batterylabunipi/TWIST/README.md

# TWIST
TWIST is an open framework for Li-ion cell characterization based on Python and Raspberry Pi
