batterylabunipi/TWIST/SW/Setting_File/chargerinfo.txt

#This file contains the model No. and the socket information about charger instrument

Model:		QPX1200SP

IPAddress:	192.168.1.101

Port:		9221
