batterylabunipi/TWIST/Docs/User_manual.pdf

## 18 febbraio 2018

# Two Wheels Instrument Station Tester (TWIST)

# User Manual

1Two Wheels Instrument Station Tester ⁽TWIST⁾ | 18/02/2018

# Two Wheels Instrument Station Tester (TWIST)

User Manual

# Summary

# 1 Hardware Framework

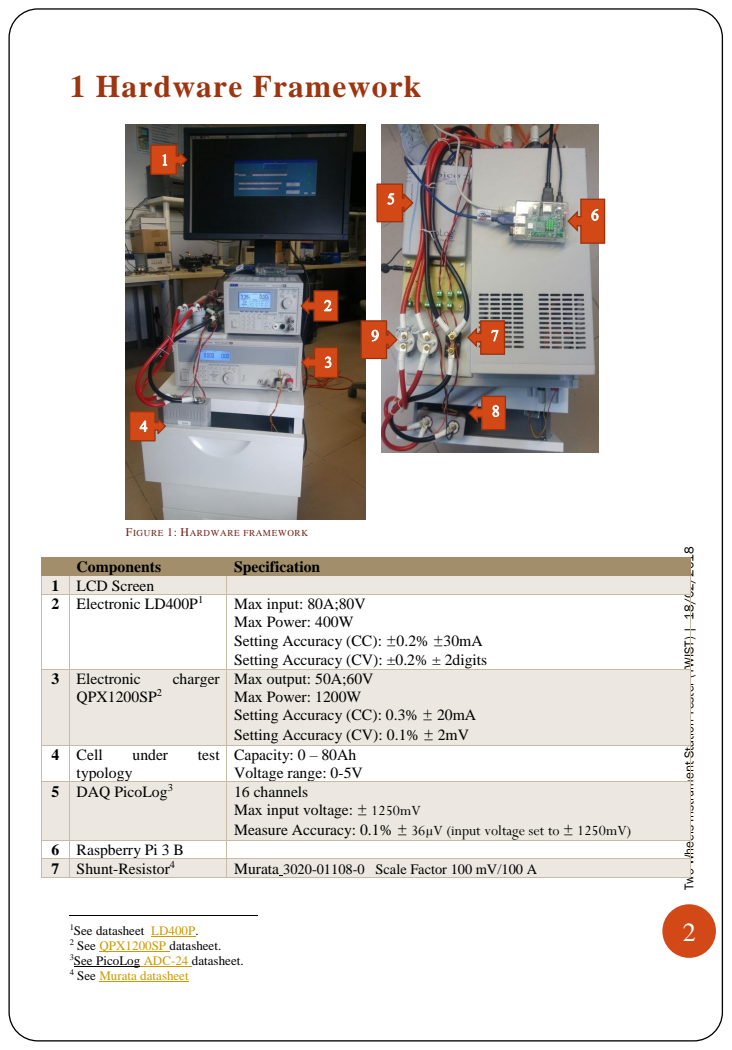
[picture p1: page 3]
Components; Specification

FIGURE 1: HARDWARE FRAMEWORK

2Two Wheels Instrument Station Tester ⁽TWIST⁾ | 18/02/2018

1 LCD Screen
2 | Electronic LD400P¹ | Max input: 80A;80V Max Power: 400W Setting Accuracy (CC): ±0.2% ±30mA Setting Accuracy (CV): ±0.2% ± 2digits

3 | Electronic charger QPX1200SP² | Max output: 50A;60V Max Power: 1200W Setting Accuracy (CC): 0.3% ± 20mA Setting Accuracy (CV): 0.1% ± 2mV

4 | Cell under test typology | Capacity: 0 – 80Ah Voltage range: 0-5V

5 DAQ PicoLog³ | | 16 channels Max input voltage: ± 1250mV Measure Accuracy: 0.1% ± 36µV (input voltage set to ± 1250mV)

6 Raspberry Pi 3 B
7 | Shunt-Resistor⁴ | Murata 3020-01108-0 Scale Factor 100 mV/100 A

1See datasheet LD400P.
2 See QPX1200SP datasheet.
3See PicoLog ADC-24 datasheet.
4 See Murata datasheet

3Two Wheels Instrument Station Tester ⁽TWIST⁾ | 18/02/2018

### 1.2 TWIST specification

# 2 Installing Procedure

1. Install Python3.4 repository on Raspbian OS. Follow the indication at https://docs.python.org/3.4/installing/index.html.
2. Install APScheduler module throught command line “sudo python3 -m pip install apscheduler”
3. Transfer TWIST folder in Raspbian OS on Raspberry Pi 3 model B.
4. Install Picolog-ADC-24 driver (libpicohrdl package) according to the procedure indicated at https://www.picotech.com/support/topic14649.html. If the installing
procedure | has | not | terminated | with | errors, | you | can | find | the
“libpicohrdl.so”,”libpicohrdl.so.2” and “libpicohardl.so.2.0.0” files, at Raspberry absolute path “/opt/picoscope/lib”;
5. Copy the “libpicohrdl.so”, ”libpicohrdl.so.2” and “libpicohardl.so.2.0.0” files in “./TWIST/SW/Sources/C++_sources”;
6. Open Geany or an equivalent g++ Integrated Development Environment (IDE).
7. Click on Build menu and then on Set building commands one;
8. Enter “g++ -Wall -c “%f” init.cc” and “g++ -Wall -o “%e” main.o init.o libpicohrdl.so”, in Compile and Build fields, respectively;
9. Start first the compiling, and then the building procedure through the Build menu of Geany IDE;
10. Type from command line: sudo chmod +x < path of main.py >;

5 See relays datasheet
6 See temperature sensor datasheet 7See Article.
8 See Article.
8 | Relays⁵ | KILOVAC LEV100 Coil voltage:12V Max Continues Current: 100A
9 | Temperature Sensor⁶ | LM35 Scale factor: 10 mV/°C
Supported test typology: | Pulse Current Test (PCT)
| Hybrid Pulse Current Test (HPCT)
Input voltage: | 0 – 4.5V
Max discharging current: | 80A
Max charging current: | 50A
Max sampling frequency: | 2Hz

Voltage Accuracy⁷
: | Offset = 21.5uV, Gain = 0.2%

Current Accuracy⁸
: | Offset = 1.256 mA, Gain = 0.075%

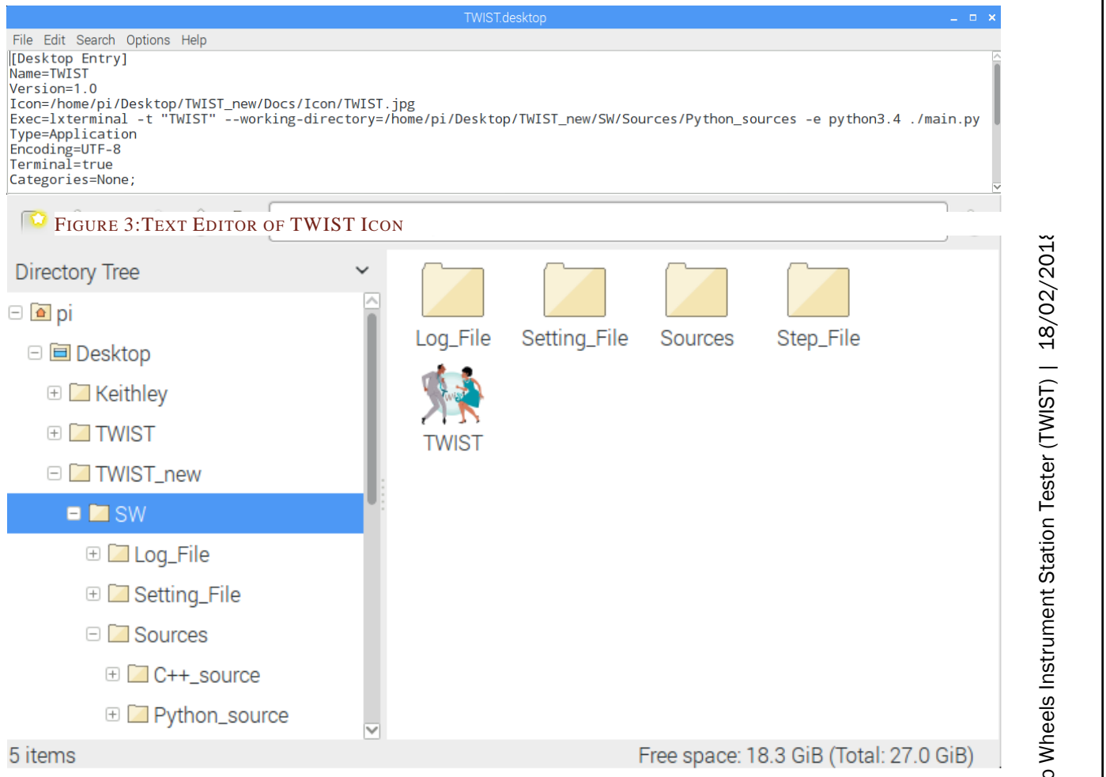
[picture p2: figure]
FIGURE 3:TEXT EDITOR OF TWIST ICON

4Two Wheels Instrument Station Tester ⁽TWIST⁾ | 18/02/2018

Note: main.py is at “./TWIST/SW/Sources/Python_sources”.

11. Change the default LAN interface settings of LOAD (LD400P) and CHARGER (QPX1200SP) according with the IP addresses and the port numbers contained in “./TWIST/SW/Setting_file/loadinfo.txt” and “./TWIST/SW/Setting_file/chargeinfo.txt”, files, respectively⁹ 10;
12. Set a static IP address on ethernet interface of raspberry PI with the same prefix of the addresses of load and charger. The procedure is indiceted at: https://www.raspberrypi.org/learning/networking-lessons/rpi-static-ip-address/. Example:
interface eth0;
static ip_address=192.168.1.11/24
13. Click on TWIST icon with mouse’s right button in “./TWIST/SW”, and select Text-Editor menu bar. Finally, insert in “Icon=” and “–working-directory=” fields, the new ABSOLUTE PATH of TWIST icon picture and of main.py, respectively (see Figure 3);

Note: the icon’s picture is available at “./TWIST/Docs/Icon

9 See LD400P user-manual p. 36.
10 See QPX1200SP user manual p.11.

FIGURE 2:./TWIST/SW FOLDER VIEW

5Two Wheels Instrument Station Tester ⁽TWIST⁾ | 18/02/2018

If the procedure is correctly done, the TWIST icon aspect will be like that shown in Figure 2.

Note: Repeat the step number 4, every time that the TWIST folder absolute path changes.

# 3. Test execution

### 3.1 Procedural test definition

Before starting the test characterization of a Li-ion cell, the operator must define the test protocol trough a specific file named “Step-file”. The file is available at “./TWIST/SW/Step_file”. The textual commands are divided in two typologies: commands and comments.

The first category produces actions on the cell through the LD400P and QPX1200SP, and it is composed by seven fields:

TYPE | LOG_EN | SAMP_TIME | TEST_LEN | TEST_I | TEST_V | STOP_I
- TYPE specifies the type of operation to perform over the cell under test, and it

can assume three values:

- Charge, define a cell charging phase.
- Discharge, define a cell discharging phase.
- Measure, define a rest cell period.
- LOG_EN can assume two values:
- 0 means that any Log-files will be generated at the end of test step.
- 1means that Log-files will be generated at the end of test step.
- SAMP_TIME specifies the LD400P and QPX1200SP sampling time in seconds.

Anyway, the DAQ Picolog sampling time is always fixed to 0.5s.

- TEST_LEN specify the total step duration in seconds. Moreover, it can assume

the value of ‘-1’. In this case, the temporal stop condition “TEST_LEN” is no

longer relevant.

- TEST_I specifies the charging or discharging current amplitude in ampere.
- TEST_V specifies the upper or lower lithium-ion cell cut-off according to the

step “TYPE”, in voltage.

- STOP_I specifies the current stop condition. If the current amplitude goes below

STOP_I value, the test ends.

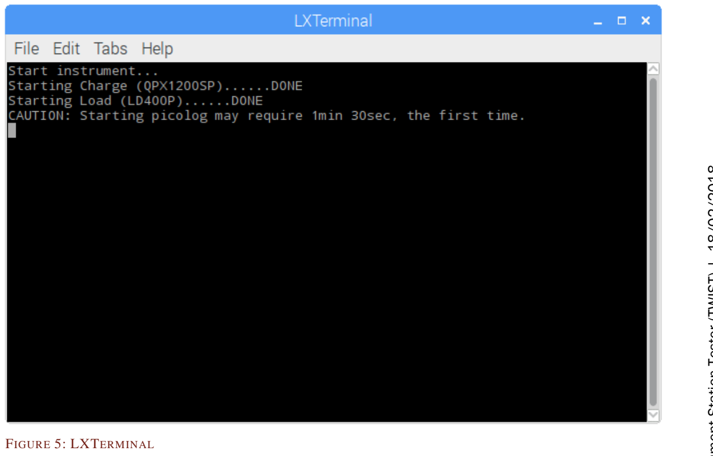
[picture p3: figure]
FIGURE 5: LXTERMINAL

6Two Wheels Instrument Station Tester ⁽TWIST⁾ | 18/02/2018

The Second instruction type are preceded by # character, and they are ignored from the program

execution. In Figure 4 a Step file instance is shown.

Note: to set the cell temperature range, the user could modify TempRange parameters

contained in textual file at “./TWIST/SW/Setting_file/picologinfo.txt”.

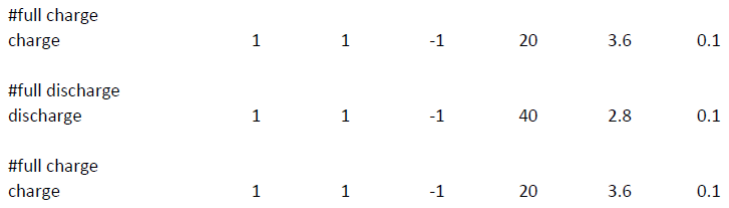
[picture p4: figure]

### 3.2 Starting phase

To start the test, the operator must click on TWIST icon. After that the LXTerminal showed in Figure 5 will open.

After the instruments initialization phase, the software asks to the user to select three folder paths. First, the operator chooses the Step-file path as show in Figure 6.

FIGURE 4: A STEP FILE INSTANCE

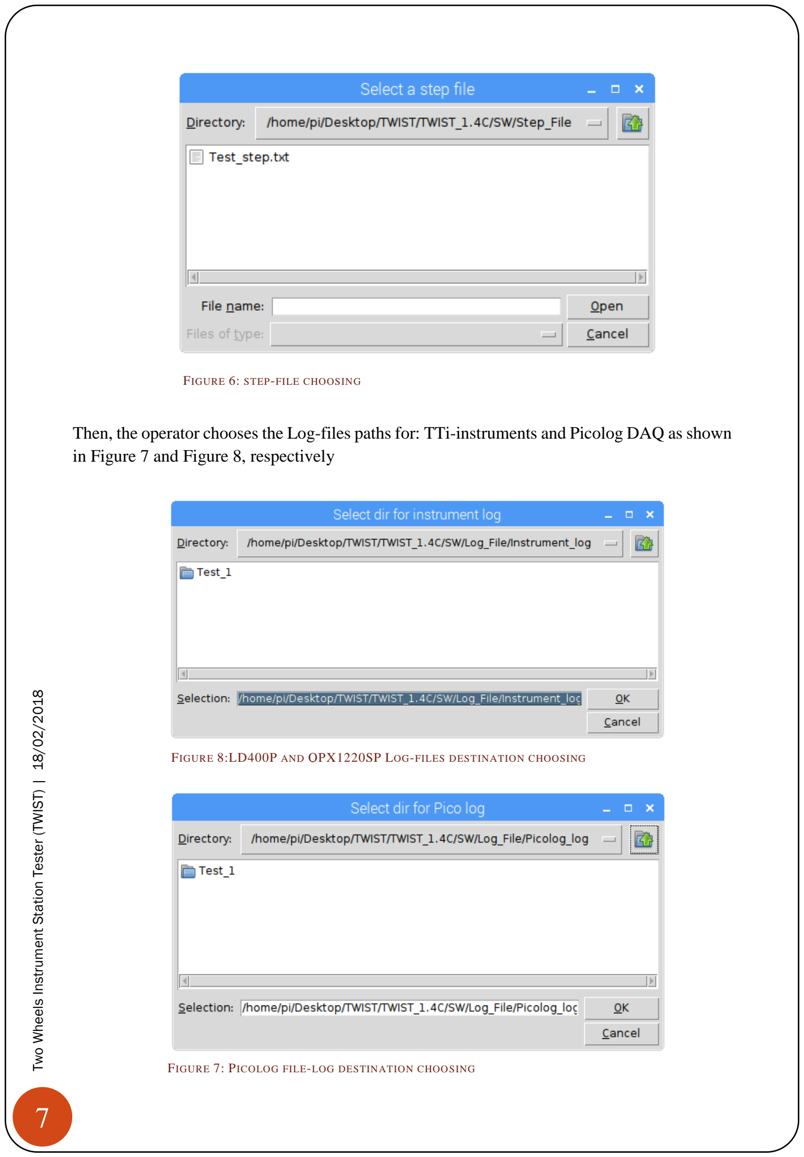
[picture p5: page 8]

7Two Wheels Instrument Station Tester ⁽TWIST⁾ | 18/02/2018

FIGURE 6: STEP-FILE CHOOSING

Then, the operator chooses the Log-files paths for: TTi-instruments and Picolog DAQ as shown in Figure 7 and Figure 8, respectively

FIGURE 8:LD400P AND QPX1220SP LOG-FILES DESTINATION CHOOSING

FIGURE 7: PICOLOG FILE-LOG DESTINATION CHOOSING

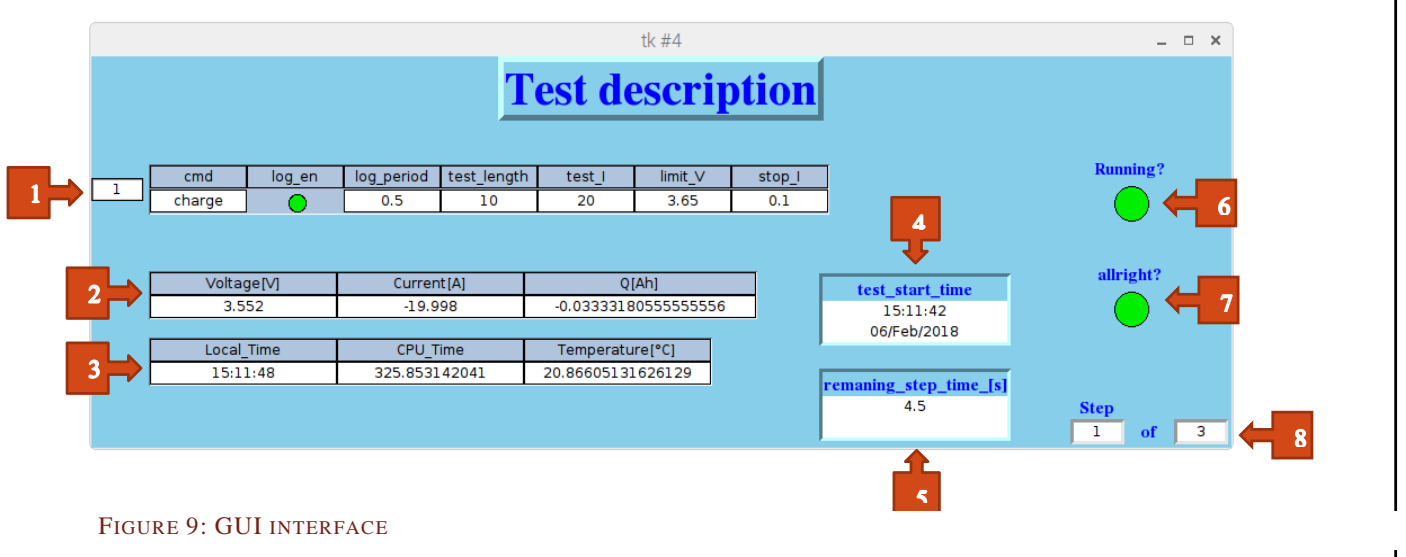
[picture p6: figure]
FIGURE 9: GUI INTERFACE

8Two Wheels Instrument Station Tester ⁽TWIST⁾ | 18/02/2018

### 3.3 Periodic acquisition phase

After starting phase operations, the program enters in the periodic acquisition of voltage, current and temperature of the cell under test. During this phase, the Graphical User Interfaces (GUI) represented in Figure 9 are opened.

### 1 Identifier number of the step-file raw in execution

### 2 Real-time cell measurement done by TTi-instruments

### 3 Time information and temperature measurements provide by Picolog DAQ

### 4 Test starting Date and Time in hh:mm:ss

5 Remaining time before the current step ending.

### 6 Running? LED indicates the test executing state of the test: if GREEN the test is still

running; if RED the test is stopped.

### 7 Allright? LED indicates the presence of SW/HW error: if GREEN any errors are still

happened else, if RED an error is occurred.

### 8 Step number indicators

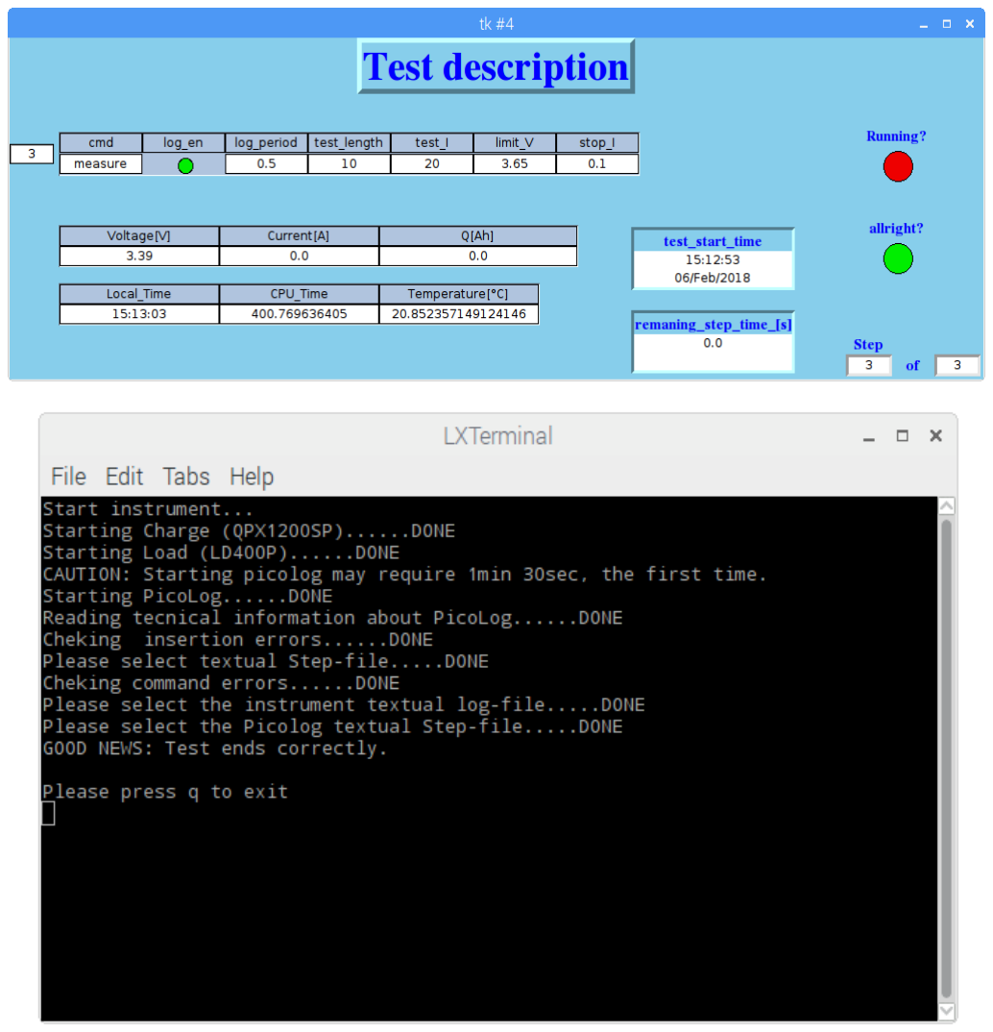
[picture p7: figure]

9Two Wheels Instrument Station Tester ⁽TWIST⁾ | 18/02/2018

### 3.4 Ending phase

The test can stop without or with HW/SW errors. In the first case, on LXTerminal the message “GOOD NEWS: Test ends correctly.” is reported, and only the “Running?” LED is RED, as shown in Figure 10.

In the second case, when an HW/SW error has occurred, on LXTerminal an error message shows an identifying error number and the name of python function within the error has occurred. At the same time, the “Running” and “Allright?” LEDs are both RED. An instance of this condition is shown in Figure 11.

To understand the meaning of the error number identifier, the operator must read the Table 1 where, the correlations between number identifier an error typology are shown.

FIGURE 10: (UP) GUI INTERFACE, (DOWN) LXTERMIANL ENDING STATE

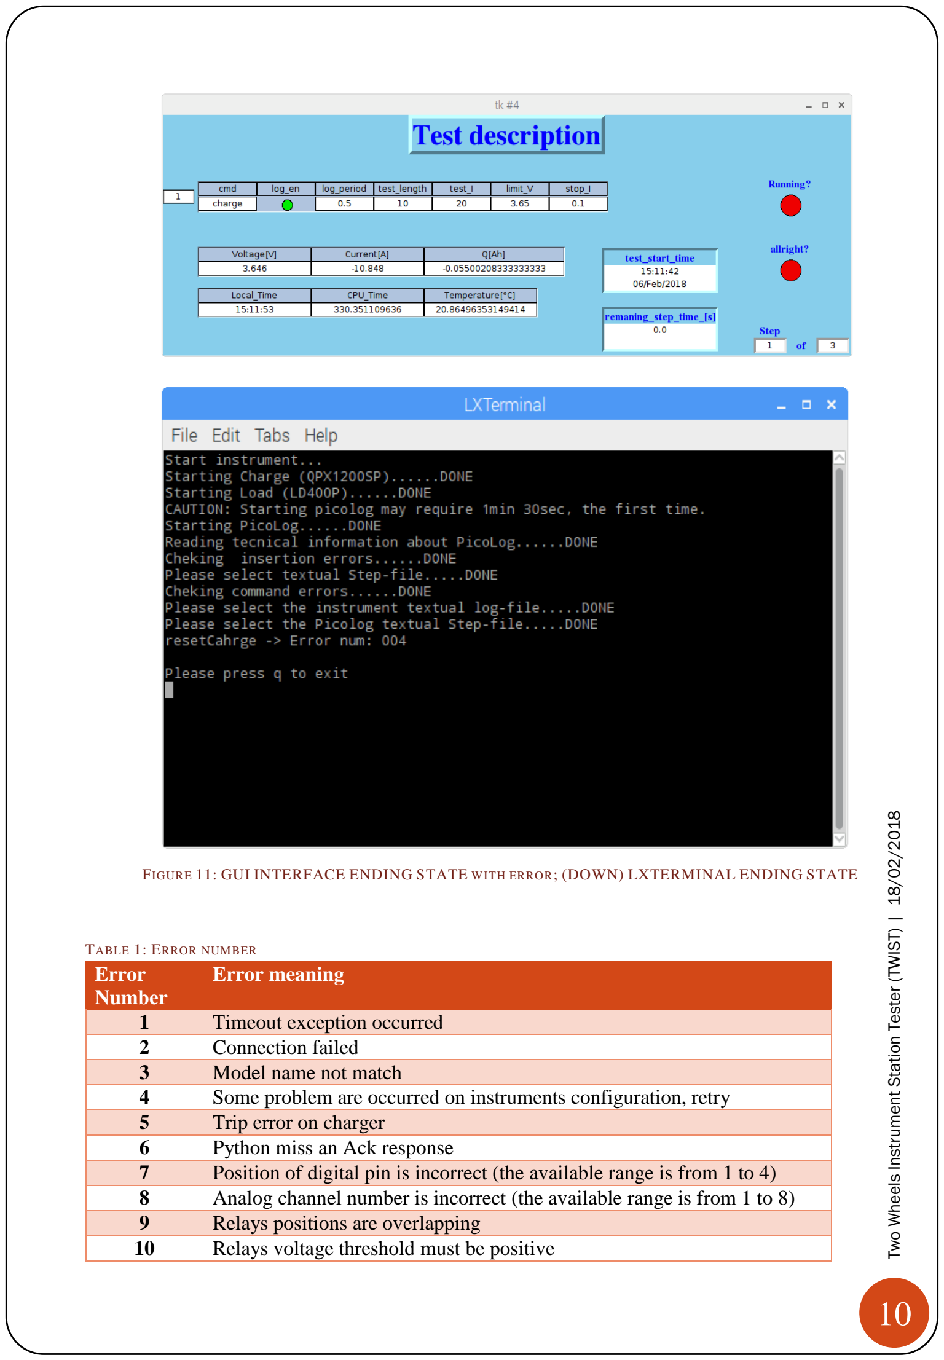
[picture p8: page 11]

# 10Two Wheels Instrument Station Tester ⁽TWIST⁾ | 18/02/2018

TABLE 1: ERROR NUMBER
Error
Number

Error meaning

1 Timeout exception occurred 2 Connection failed 3 Model name not match 4 Some problem are occurred on instruments configuration, retry 5 Trip error on charger 6 Python miss an Ack response 7 Position of digital pin is incorrect (the available range is from 1 to 4) 8 Analog channel number is incorrect (the available range is from 1 to 8) 9 Relays positions are overlapping 10 Relays voltage threshold must be positive

FIGURE 11: GUI INTERFACE ENDING STATE WITH ERROR; (DOWN) LXTERMINAL ENDING STATE

# 11Two Wheels Instrument Station Tester ⁽TWIST⁾ | 18/02/2018

# 4.Data extraction

When test ending, all Log-files are saved in the paths previously chose by the user. For each step, two type of Log-files are generated: one by TTi instruments and one by Picolog DAQ; as shown in Figure 12 and Figure 13.

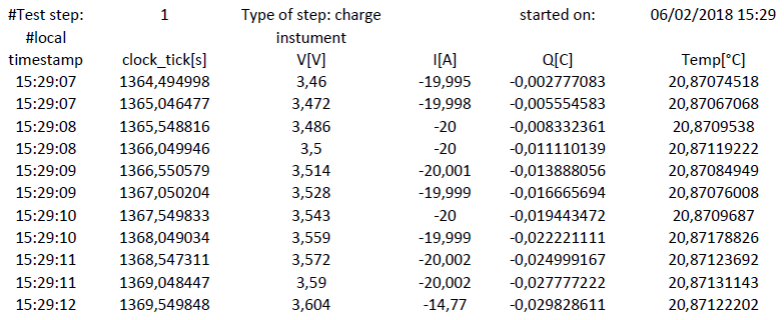
[picture p9: figure]

FIGURE 12: TTI INSTRUMENTS FILE LOG VIEW

### 11 The number of bit used in Picolog ADC-Channel conversion must be

positive

12 Tmin,Tmax values must be positive 13 Tmin must be smaller than Tmax 14 The number of columns of command raw must be 7 15 TestLength must be bigger than 0,5s 16 TestLength mast be multiple of sample time 17 Sample time range is from 0,5s to 2 s 18 Sample time must be a multiple of 0,5s 19 TestLength must be bigger than sample time 20 Writing errors in command raw, the correct types are

"charge","discharge","measure"

### 21 LOG_EN must be 1 or 0 22 Sharing buffer between dataAcquisition thread and main thread is empty 23 Sharing buffer between dataAcquisition thread and main thread is full 24 CAUTION: Safe temperature range exceeding 25 CAUTION: Some issues is present on relay state, checking hardware is

required

### 26 CAUTION: Some issues is present on powerline, checking hardware is

required

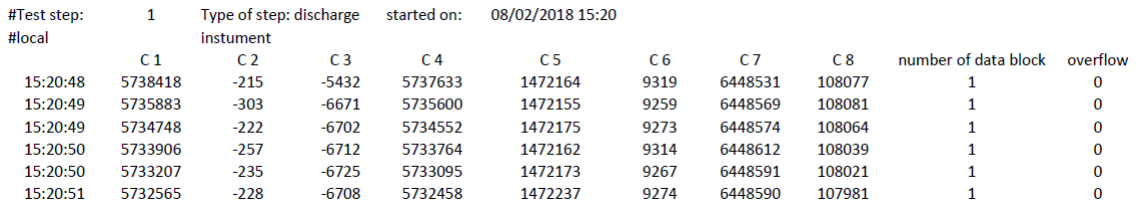
[picture p10: figure]

# 12Two Wheels Instrument Station Tester ⁽TWIST⁾ | 18/02/2018

As shown in Figure 13, the data acquired by Picolog ADC-24 are shown as a 32bit integer. The integer represents the Picolog ADC-24 Analog-Digital Converter (ADC) coding. To decoding these values, the equation (1) is need.

Datadecoding = Datacoding ∗

(

Vrangein
2

)

Nbit − 1

∗ Coeff | (1)

where:

-Vrangein is the Picolog ADC-channels voltage input range (it is chosen of ± 1.250 mV, so Vrangein = 2500 mV);
-Nbit is the conversion bit number of ADC-Channels (24bit);
-Coeff is a coefficient which value change according with the kind of measurement that a single ADC-Channel has to performe (the Coeff values are reported in Table 2 and Table 3).

The Coeff’s values are strictly dependent to the hardware framework of the system. In this case the values are correlated to the use of:

- A 4 time voltage divider in the cell voltage measurement path (See the file source of hardware at “./TWIST/HW”;
- A shunt-resistor with a scale factor of 1 mV/A (sensor for current measurement);
- LM35 sensor for cell temperature measurement with a scale factor of 10 mV/°C

FIGURE 13 PICOLOG DAQ LOG-FILE VIEW

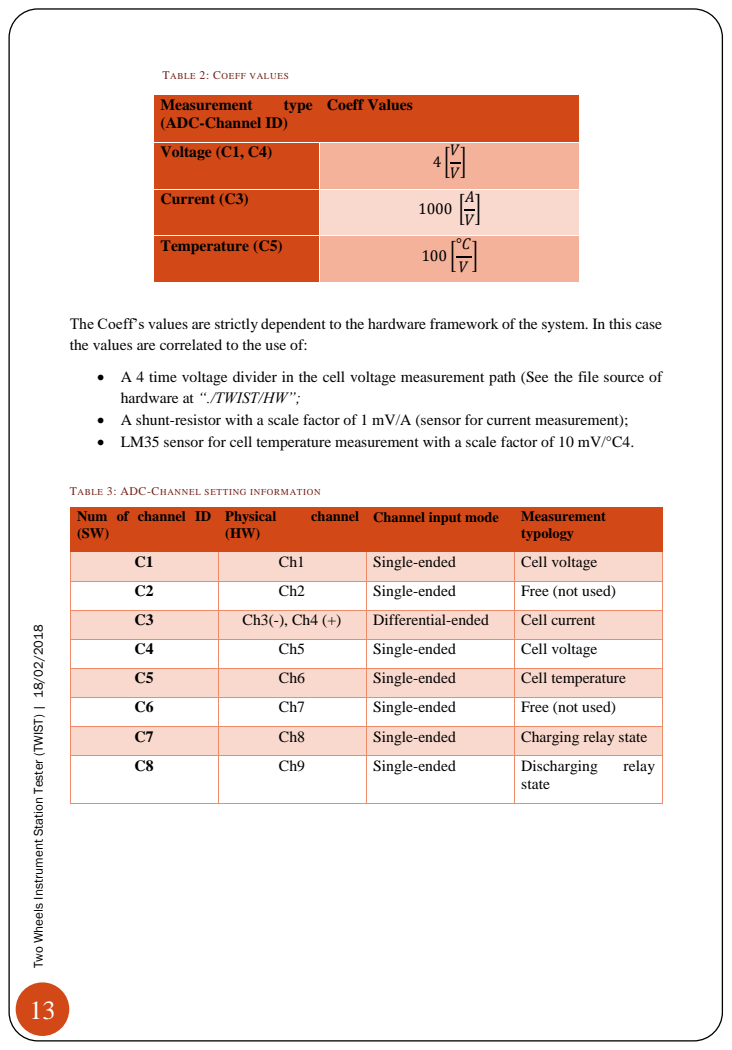
[picture p11: page 14]

Voltage (C1, C4) | V 4 [ ] V

Current (C3) | A 1000 [ ] V

Temperature (C5) | °C 100 [ ] V

The Coeff’s values are strictly dependent to the hardware framework of the system. In this case
the values are correlated to the use of:

• A 4 time voltage divider in the cell voltage measurement path (See the file source of
hardware at “./TWIST/HW”;
• A shunt-resistor with a scale factor of 1 mV/A (sensor for current measurement);
• LM35 sensor for cell temperature measurement with a scale factor of 10 mV/°C4.

TABLE 3: ADC-CHANNEL SETTING INFORMATION

Num of channel ID

C1 | Ch1 | Single-ended | Cell voltage

C2 | Ch2 | Single-ended | Free (not used)

C3 | Ch3(-), Ch4 (+) | Differential-ended | Cell current

13Two Wheels Instrument Station Tester ⁽TWIST⁾ | 18/02/2018

C4 | Ch5 | Single-ended | Cell voltage

C5 | Ch6 | Single-ended | Cell temperature

C6 | Ch7 | Single-ended | Free (not used)

C7 | Ch8 | Single-ended | Charging relay state

C8 | Ch9 | Single-ended | Discharging relay state
