batterylabunipi/TWIST/HW/TWIST_tester.kicad_pcb

## KiCad design HW/TWIST_tester.kicad_pcb (2018-10-03)

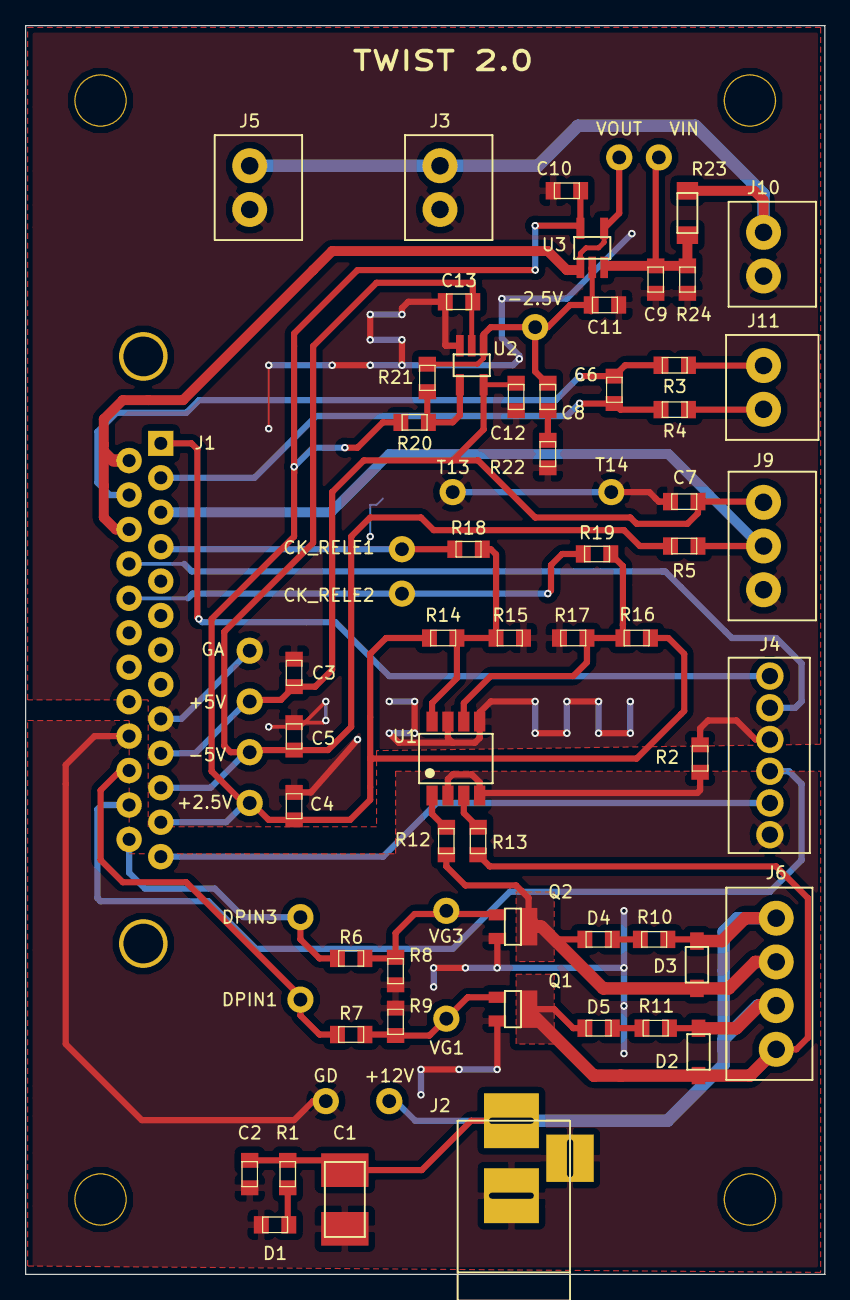
[picture p14: board TWIST_tester.kicad_pcb from above]

Board: 2 copper layers, 64.0 x 100.0 mm, 73 parts (0 on the bottom side), 36 nets.

Parts:
+2.5V, +5V, +12V: TestPoint; TSTPOINT
-2.5V, -5V: TestPoint; TSTPOINT
C1: 100uF; C_2312
C2, C3, C4, C5, C10, C11, C12, C13: 100nF; 0805
C6: 100u; 0805
C7: 100nf; 0805
C8: 1u; 0805
C9: 1uF; 0805
CK_RELE1, CK_RELE2: TestPoint; TSTPOINT
D1: LED_G; 0805
D2, D3: MBR0520L; SOD-123
D4: LED_Y; 0805
D5: LED_R; 0805
DPIN1, DPIN3: TestPoint; TSTPOINT
GA: TestPoint; TSTPOINT
GD: TestPoint; TSTPOINT
J1: DB25_MALE; DB25MC
J2: ALIM_JACK; conn_alim
J3, J5, J10: morsett_1x02_MALE; morsett_1x02
J4: CONN_01X06; morsett_1x06_CB
J6: CONN_01X04_MALE; morsett_1x04
J9: morsett_1x03_MALE; morsett_1x03
J11: morsett_1x02_MALE; morsett_1x02_G
Q1, Q2: DMG3420U; SOT-23-3-POT
R1, R3, R4, R10, R11: 1k; 0805
R2, R14, R16: 100k; 0805
R5, R8, R9: 100K; 0805
R6, R7: 10K; 0805
R12, R13: 1K; 0805
R15, R17: 66.5k; 0805
R18, R19: 0; 0805
R20, R21: 1M; 0805
R22: 2k; 0805
R23: 990K; R_1206
R24: 330K; 0805
T13, T14: TestPoint; TSTPOINT
U1: VOD205T; 8-SOIC
U2: LT6003; SOT-23-5
U3: ADA4051; SOT-23-5
VG1, VG3: TestPoint; TSTPOINT
VIN: TestPoint; TSTPOINT
VOUT: TestPoint; TSTPOINT

Connections:
+2V5: +2.5V.1, C4.1, C10.1, J1.12, R14.1, R16.1, R20.2, U3.5
+5V: +5V.1, C3.1, C7.1, C12.1, J1.10, J9.1, U2.5
+12V: +12V.1, C1.1, C2.1, D2.1, D3.1, J2.1, J6.2, J6.4, R1.1, R10.1, R11.1
-5V: -5V.1, C5.1, C13.2, J1.11, R5.2, U2.2
/CH2: J1.1, J4.6
/CH7: J1.17, J4.5
/CHK_RE1: CK_RELE1.1, J1.4, R18.1
/CHK_RE2: CK_RELE2.1, J1.18, R19.1
/COIL1-: D3.2, D4.1, J6.3, Q2.3, R12.2
/COIL2-: D2.2, D5.1, J6.1, Q1.3, R13.2
/DPIN1: DPIN1.1, J1.23, R7.1
/DPIN2: J1.24, J4.3
/DPIN3: DPIN3.1, J1.25, R6.1
/DPIN4: J1.13, J4.2
/SHUNT+: C6.1, J1.15, R3.2
/SHUNT-: C6.2, J1.2, R4.2
/TEMP: J1.3, J9.2, R5.1
/VB+: J3.1, J5.1, J10.1, R23.1
/VBATT+: J1.14, J1.16, U3.1, U3.4, VOUT.1
GNDA: C3.2, C4.2, C5.2, C7.2, C9.2, C10.2, C11.2, C12.2, C13.1, GA.1, J1.9, J3.2, J4.4, J5.2, J9.3, J10.2, R2.2, R15.2, R17.2, R22.2, R24.2, T13.1, T14.1, U1.5, U1.7, U2.3
GNDD: C1.2, C2.2, D1.1, GD.1, J1.22, J2.2, J2.3, J4.1, Q1.2, Q2.2, R2.1, R8.2, R9.2, U1.2, U1.4
unnamed: C8.2, R22.1
unnamed: C9.1, R23.2, R24.1, U3.3, VIN.1
unnamed: -2.5V.1, C8.1, C11.1, R21.1, U2.1, U3.2
unnamed: D1.2, R1.2
unnamed: D4.2, R10.2
unnamed: D5.2, R11.2
unnamed: J11.1, R3.1
unnamed: J11.2, R4.1
unnamed: Q1.1, R7.2, R9.1, VG1.1
unnamed: Q2.1, R6.2, R8.1, VG3.1
unnamed: R12.1, U1.1
unnamed: R13.1, U1.3
unnamed: R14.2, R15.1, R18.2, U1.8
unnamed: R16.2, R17.1, R19.2, U1.6
unnamed: R20.1, R21.2, U2.4
